spacecraft-design-lab-2019/avionics-motherboard/README.md

# avionics-motherboard
Main flight computer board for the PyCubed-1 spacecraft

Snapshot: 2019-10-24 maholli
<p align="middle">
  
</p>
