spacecraft-design-lab-2019/avionics-motherboard/bot.PNG

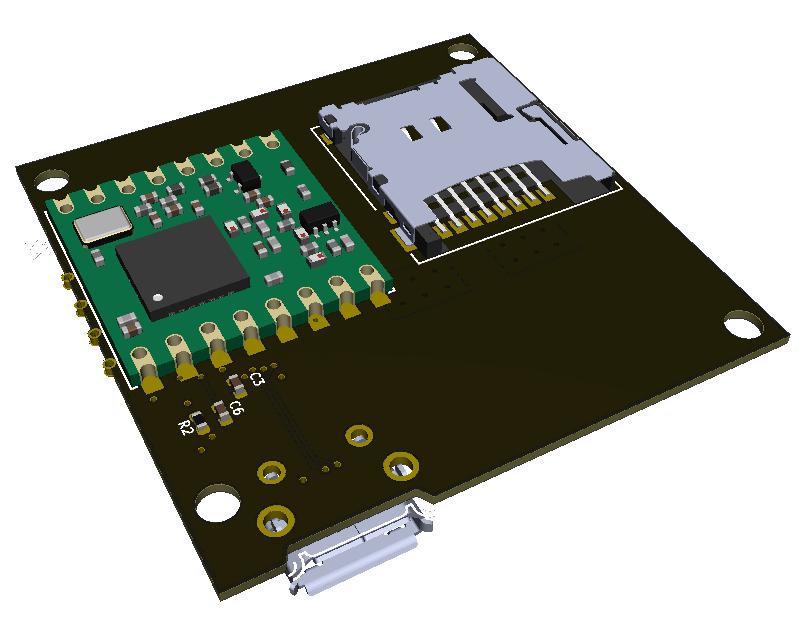
bot.PNG
