spacecraft-design-lab-2019/avionics-motherboard/top.PNG

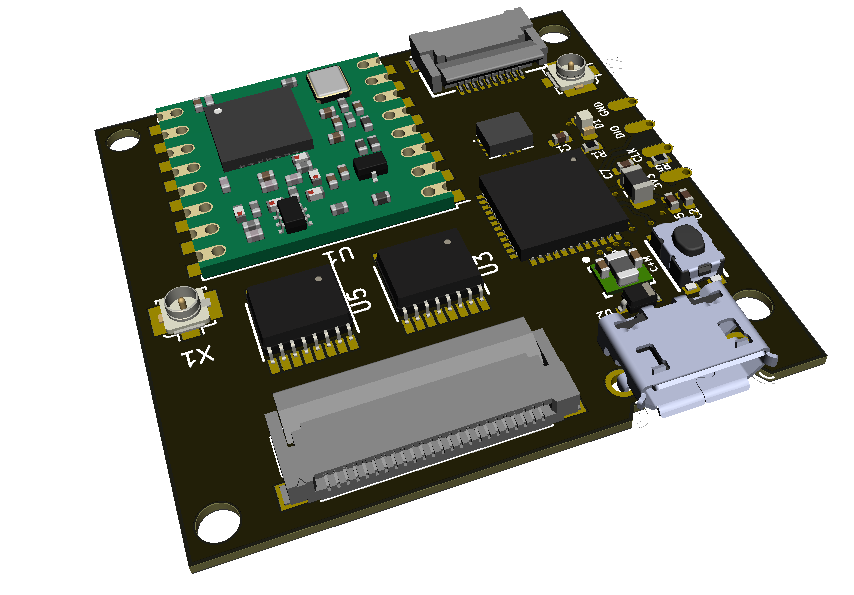
top.PNG
