spacecraft-design-lab-2019/avionics-motherboard/mainboard.kicad_pcb

## KiCad design mainboard.kicad_pcb (2019-10-28)

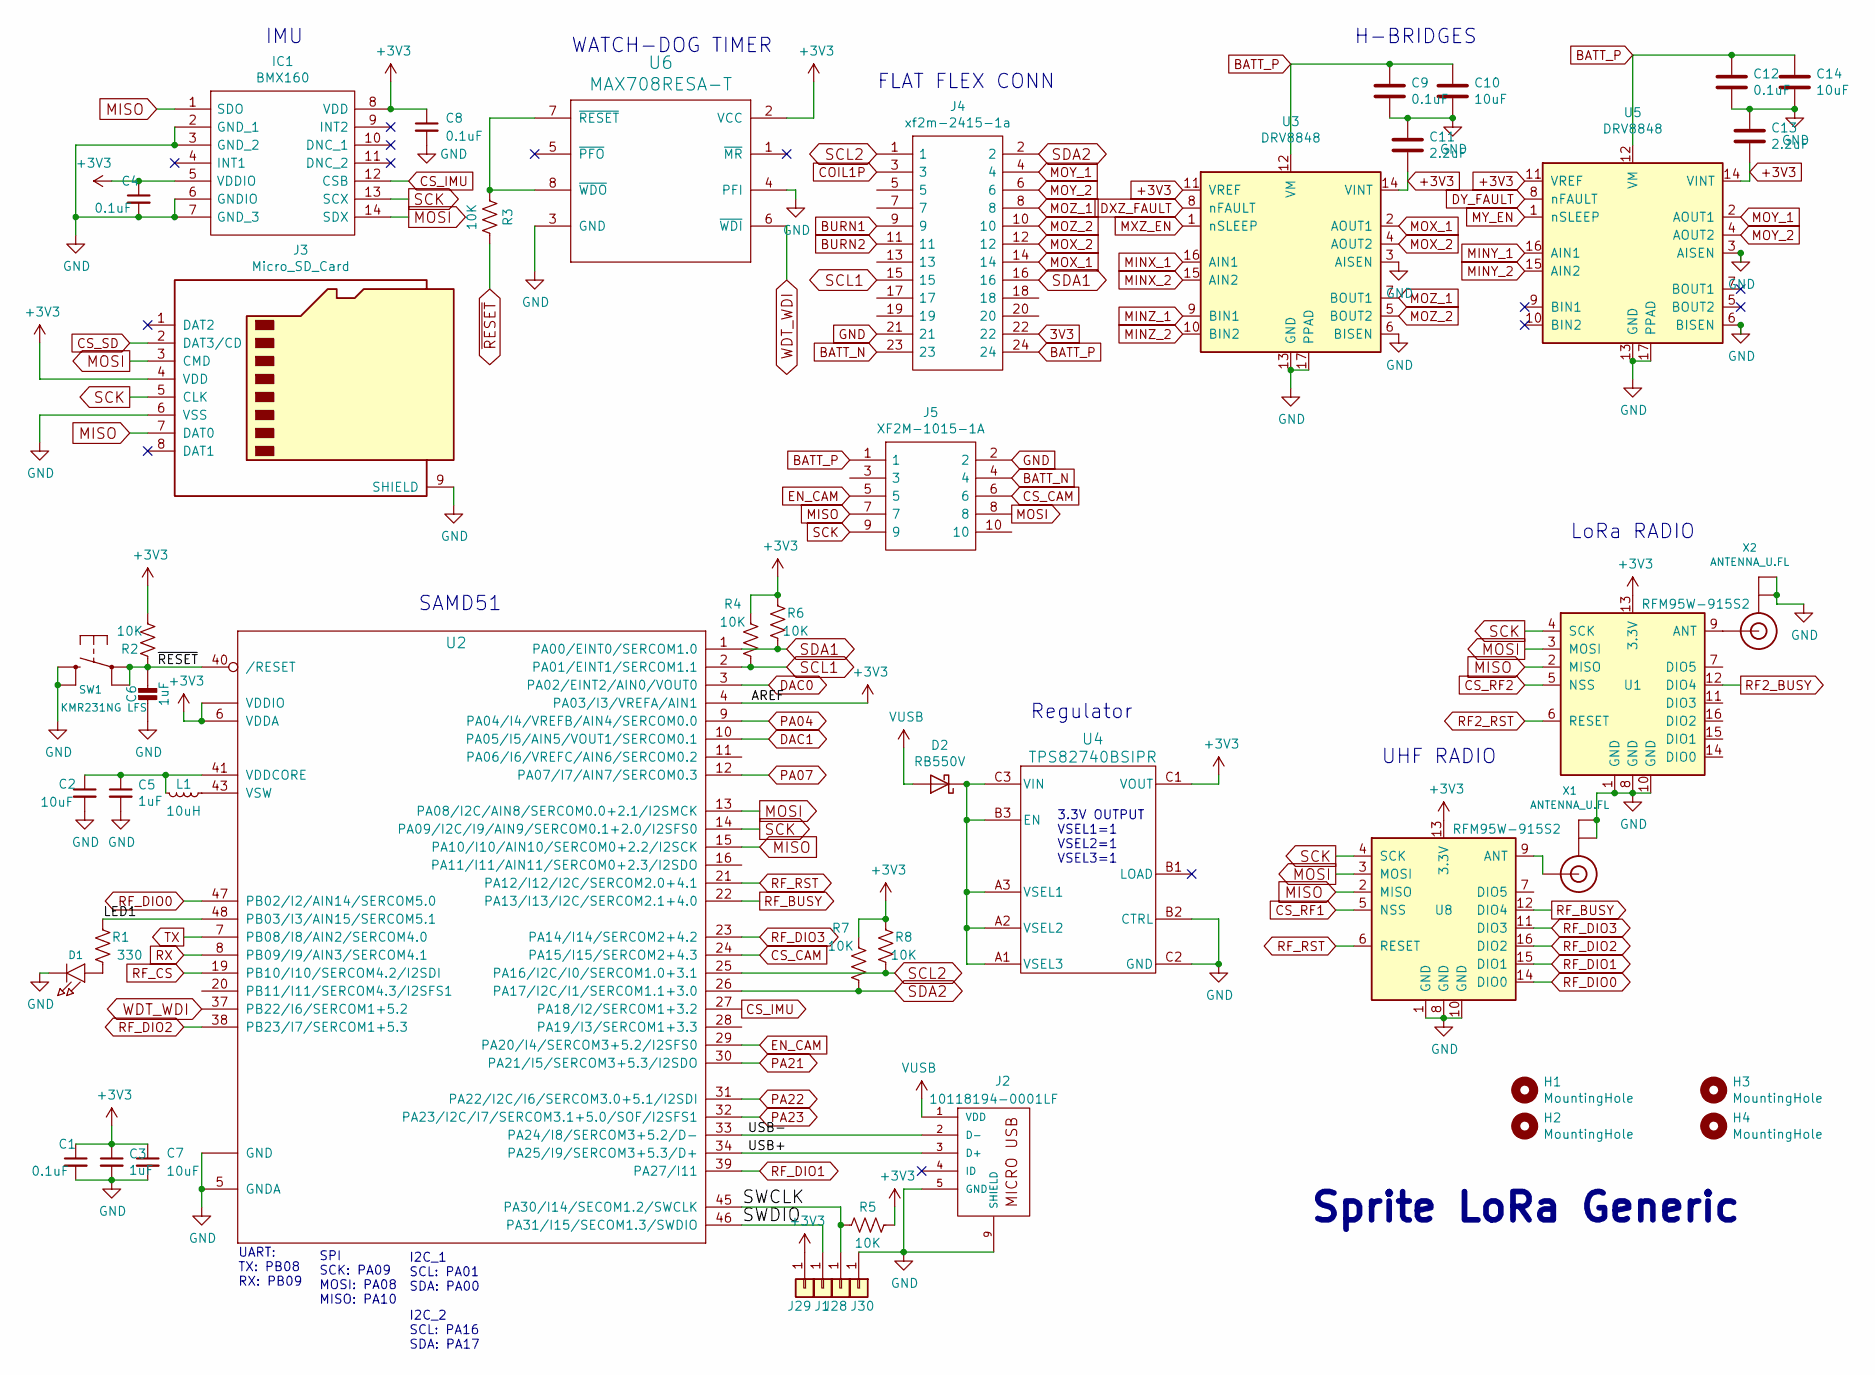
[picture p5: schematic mainboard.sch, Sprite-2019]

Parts:
C1, C4, C8, C9, C12: 0.1uF; C_0402_1005Metric
C2, C7, C10, C14: 10uF; C_0402_1005Metric
C3, C5, C6: 1uF; C_0402_1005Metric
C11, C13: 2.2uF; C_0402_1005Metric
D1: GREEN; LED_0603_1608Metric
D2: RB550V; D_SOD-323
H1, H2, H3, H4: MountingHole; MountingHole_2.2mm_M2
IC1: BMX160; Manufacturer_Part_Number BMX160; Mouser Part Number 262-BMX160
J1, J28, J29, J30: Conn_01x01; castellated_small_1side
J2: 10118194-0001LF
J3: Micro_SD_Card; 503182-1853_MOLEX-MicroSD
J4: xf2m-2415-1a; XF2M-2415-1A
J5: XF2M-1015-1A; Manufacturer_Part_Number XF2M-1015-1A; Mouser Part Number 653-XF2M-1015-1A
L1: 10uH; L_0805_2012Metric
R1: 330; R_0402_1005Metric
R2, R3, R4, R5, R6, R7, R8: 10K; R_0402_1005Metric
SW1: KMR231NG LFS; BTN_KMR2_4.6X2.8
U1, U8: RFM95W-915S2; HOPERF_RFM9XW_SMD
U2: ATSAMD51G_TQFN48; QFN50P700X700X90-49N-D
U3, U5: DRV8848; SOP65P640X120-17N
U4: TPS82740BSIPR; TPS82740ASIPR
U6: MAX708RESA-T; SO-8_3.9x4.9mm_P1.27mm
X1, X2: ANTENNA_U.FL; U.FL_Molex_MCRF_73412-0110_Vertical

Connections:
3V3: J4.22
+3V3: C1.1, C3.1, C4.1, C7.1, C8.1, C11.2, C13.2, IC1.5 (VDDIO), IC1.8 (VDD), J3.4 (VDD), J29.1, R2.2, R4.2, R5.1, R6.2, R7.2, R8.2, U1.13 (3.3V), U2.4 (PA03/I3/VREFA/AIN1), U2.6 (VDDA), U2.17 (VDDIO), U2.36 (VDDIO), U2.44 (VDDIO), U3.11 (VREF), U3.14 (VINT), U4.C1 (VOUT), U5.11 (VREF), U5.14 (VINT), U6.2 (VCC), U8.13 (3.3V)
/LED1: R1.2, U2.48 (PB03/I3/AIN15/SERCOM5.1)
/SWCLK: J28.1, R5.2, U2.45 (PA30/I14/SECOM1.2/SWCLK)
/SWDIO: J1.1, U2.46 (PA31/I15/SECOM1.3/SWDIO)
/USB+: J2.3 (D+), U2.34 (PA25/I9/SERCOM3+5.3/D+)
/USB-: J2.2 (D-), U2.33 (PA24/I8/SERCOM3+5.2/D-)
BATT_N: J4.23, J5.4
BATT_P: C9.1, C10.1, C12.1, C14.1, J4.24, J5.1, U3.12 (VM), U5.12 (VM)
BURN1: J4.9
BURN2: J4.11
COIL1P: J4.3
CS_CAM: J5.6, U2.24 (PA15/I15/SERCOM2+4.3)
CS_IMU: IC1.12 (CSB), U2.27 (PA18/I2/SERCOM1+3.2)
CS_RF1: U8.5 (NSS)
CS_RF2: U1.5 (NSS)
CS_SD: J3.2 (DAT3/CD)
DAC0: U2.3 (PA02/EINT2/AIN0/VOUT0)
DAC1: U2.10 (PA05/I5/AIN5/VOUT1/SERCOM0.1)
DXZ_FAULT: U3.8 (nFAULT)
DY_FAULT: U5.8 (nFAULT)
EN_CAM: J5.5, U2.29 (PA20/I4/SERCOM3+5.2/I2SFS0)
GND: C1.2, C2.2, C3.2, C4.2, C5.2, C6.1, C7.2, C8.2, C9.2, C10.2, C11.1, C12.2, C13.1, C14.2, D1.2, IC1.2 (GND_1), IC1.3 (GND_2), IC1.6 (GNDIO), IC1.7 (GND_3), J2.5 (GND), J2.8, J2.9 (SHIELD), J3.6 (VSS), J3.9 (SHIELD), J4.21, J5.2, J30.1, SW1.B (S), SW1.B' (S1), U1.1 (GND), U1.8 (GND), U1.10 (GND), U2.5 (GNDA), U2.18 (GND), U2.35 (GND), U2.42 (GND), U2.49, U3.3 (AISEN), U3.6 (BISEN), U3.13 (GND), U3.17 (PPAD), U4.B2 (CTRL), U4.C2 (GND), U5.3 (AISEN), U5.6 (BISEN), U5.13 (GND), U5.17 (PPAD), U6.3 (GND), U6.4 (PFI), U8.1 (GND), U8.8 (GND), U8.10 (GND), X1.1 (GND@0), X1.2 (GND@1), X2.1 (GND@0), X2.2 (GND@1)
MINX_1: U3.16 (AIN1)
MINX_2: U3.15 (AIN2)
MINY_1: U5.16 (AIN1)
MINY_2: U5.15 (AIN2)
MINZ_1: U3.9 (BIN1)
MINZ_2: U3.10 (BIN2)
MISO: IC1.1 (SDO), J3.7 (DAT0), J5.7, U1.2 (MISO), U2.15 (PA10/I10/AIN10/SERCOM0+2.2/I2SCK), U8.2 (MISO)
MOSI: IC1.14 (SDX), J3.3 (CMD), J5.8, U1.3 (MOSI), U2.13 (PA08/I2C/AIN8/SERCOM0.0+2.1/I2SMCK), U8.3 (MOSI)
MOX_1: J4.14, U3.2 (AOUT1)
MOX_2: J4.12, U3.4 (AOUT2)
MOY_1: J4.4, U5.2 (AOUT1)
MOY_2: J4.6, U5.4 (AOUT2)
MOZ_1: J4.8, U3.7 (BOUT1)
MOZ_2: J4.10, U3.5 (BOUT2)
MXZ_EN: U3.1 (nSLEEP)
MY_EN: U5.1 (nSLEEP)
unnamed: C2.1, C5.1, L1.2, U2.41 (VDDCORE)
unnamed: D1.1, R1.1
unnamed: D2.1 (K), U4.A1 (VSEL3), U4.A2 (VSEL2), U4.A3 (VSEL1), U4.B3 (EN), U4.C3 (VIN)
unnamed: L1.1, U2.43 (VSW)
unnamed: R3.2, U6.7 (~RESET), U6.8 (~WDO)
unnamed: U1.9 (ANT), X2.3 (SIGNAL)
unnamed: U8.9 (ANT), X1.3 (SIGNAL)
PA04: U2.9 (PA04/I4/VREFB/AIN4/SERCOM0.0)
PA07: U2.12 (PA07/I7/AIN7/SERCOM0.3)
PA21: U2.30 (PA21/I5/SERCOM3+5.3/I2SDO)
PA22: U2.31 (PA22/I2C/I6/SERCOM3.0+5.1/I2SDI)
PA23: U2.32 (PA23/I2C/I7/SERCOM3.1+5.0/SOF/I2SFS1)
RF2_BUSY: U1.12 (DIO4)
RF2_RST: U1.6 (RESET)
RF_BUSY: U2.22 (PA13/I13/I2C/SERCOM2.1+4.0), U8.12 (DIO4)
RF_CS: U2.19 (PB10/I10/SERCOM4.2/I2SDI)
RF_DIO0: U2.47 (PB02/I2/AIN14/SERCOM5.0), U8.14 (DIO0)
RF_DIO1: U2.39 (PA27/I11), U8.15 (DIO1)
RF_DIO2: U2.38 (PB23/I7/SERCOM1+5.3), U8.16 (DIO2)
RF_DIO3: U2.23 (PA14/I14/SERCOM2+4.2), U8.11 (DIO3)
RF_RST: U2.21 (PA12/I12/I2C/SERCOM2.0+4.1), U8.6 (RESET)
RX: U2.8 (PB09/I9/AIN3/SERCOM4.1)
SCK: IC1.13 (SCX), J3.5 (CLK), J5.9, U1.4 (SCK), U2.14 (PA09/I2C/I9/AIN9/SERCOM0.1+2.0/I2SFS0), U8.4 (SCK)
SCL1: J4.15, R4.1, U2.2 (PA01/EINT1/SERCOM1.1)
SCL2: J4.1, R8.1, U2.25 (PA16/I2C/I0/SERCOM1.0+3.1)
SDA1: J4.16, R6.1, U2.1 (PA00/EINT0/SERCOM1.0)
SDA2: J4.2, R7.1, U2.26 (PA17/I2C/I1/SERCOM1.1+3.0)
TX: U2.7 (PB08/I8/AIN2/SERCOM4.0)
VUSB: D2.2 (A), J2.1 (VDD)
WDT_WDI: U2.37 (PB22/I6/SERCOM1+5.2), U6.6 (~WDI)
~RESET: C6.2, R2.1, R3.1, SW1.A, SW1.A' (P1), U2.40 (/RESET)

Notes on the sheet:
Regulator
3.3V OUTPUT VSEL1=1 VSEL2=1 VSEL3=1
SAMD51
UHF RADIO
Sprite LoRa Generic
LoRa RADIO
H-BRIDGES
WATCH-DOG TIMER
IMU
FLAT FLEX CONN
UART: TX: PB08 RX: PB09
SPI SCK: PA09 MOSI: PA08 MISO: PA10
I2C_1 SCL: PA01 SDA: PA00 I2C_2 SCL: PA16 SDA: PA17

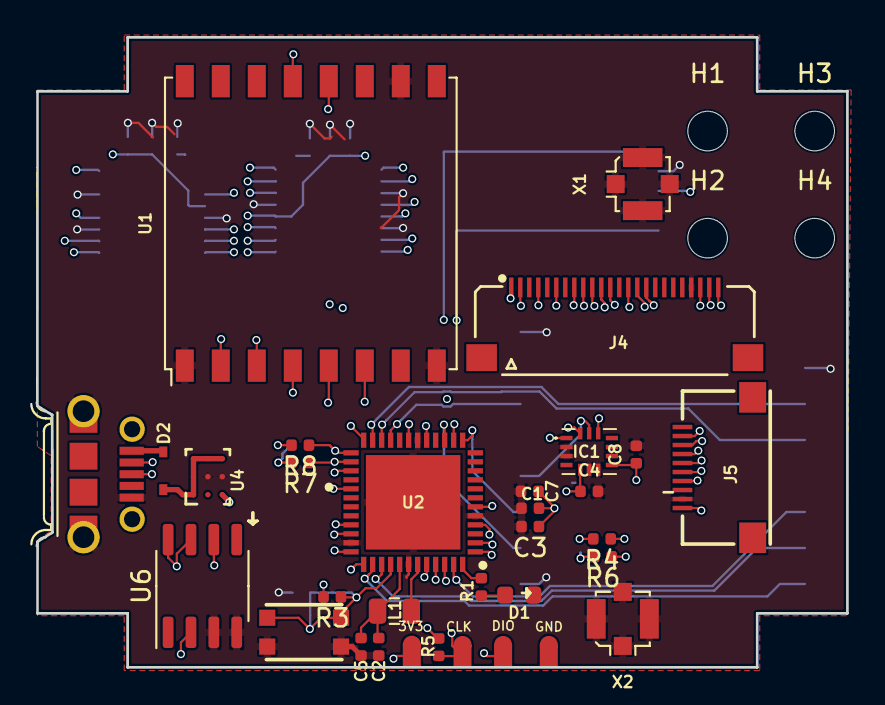
[picture p6: board mainboard.kicad_pcb from above]

Board: 4 copper layers, 45.0 x 35.0 mm, 48 parts (0 on the bottom side), 39 nets.
