spacecraft-design-lab-2019/avionics-motherboard/rf-test/spriteSAMD.kicad_pcb

## KiCad design rf-test/spriteSAMD.kicad_pcb (2019-10-27)

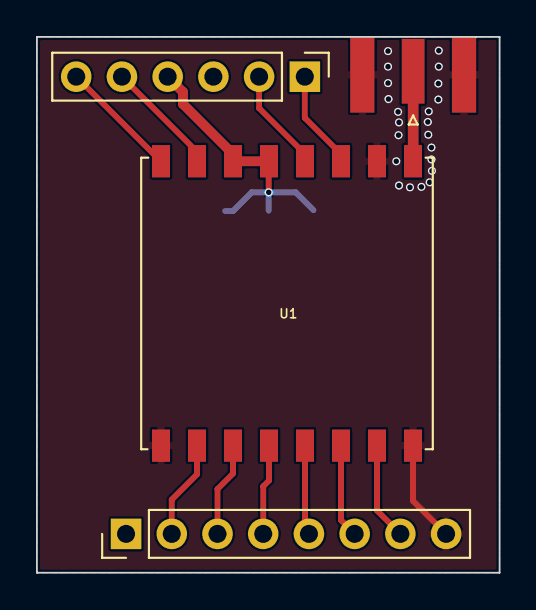
[picture p7: board spriteSAMD.kicad_pcb from above]

Board: 2 copper layers, 25.7 x 29.8 mm, 7 parts (0 on the bottom side), 13 nets.

Parts:
C1: 0.1uF; C_0402_1005Metric
C2: 1uF; C_0402_1005Metric
C3: 10uF; C_0402_1005Metric
J1: Conn_01x08_Female; PinHeader_1x08_P2.54mm_Vertical
J2: Conn_Coaxial; SMA_Samtec_SMA-J-P-H-ST-EM1_EdgeMount
J3: Conn_01x08_Female; PinHeader_1x06_P2.54mm_Vertical
U1: RFM95W-915S2; HOPERF_RFM9XW_SMD

Connections:
GND: C1.2, C2.2, C3.2, J1.8, J2.2, U1.1, U1.8, U1.10
MISO: J1.2, U1.2
MOSI: J1.3, U1.3
unnamed: J2.1, U1.9
P7: J1.7, U1.7
RF_BUSY: J3.2, U1.12
RF_CS: J1.5, U1.5
RF_DIO0: C1.1, C2.1, C3.1, J3.4, U1.13, U1.14
RF_DIO1: J3.5, U1.15
RF_DIO2: J3.6, U1.16
RF_DIO3: J3.1, U1.11
RF_RST: J1.6, U1.6
SCK: J1.4, U1.4
