spacecraft-design-lab-2019/avionics-motherboard/(commit log)

2019-10-19 the will-it-all-fit test... ✔
    [Motherboard.kicad_pcb, Motherboard.sch, spriteSAMD.kicad_pcb, spriteSAMD.sch]
2019-10-19 if I fits... 😺
2019-10-19 added WDT and took closer-look at fit
    [spriteSAMD.kicad_pcb]
2019-10-19 labeled schematic in case anyone ends up seeing this
    [spriteSAMD.kicad_pcb, spriteSAMD.sch]
2019-10-20 changed KiCad project name and fixed linking
    [mainboard.kicad_pcb, mainboard.sch, spriteSAMD.kicad_pcb, spriteSAMD.sch]
2019-10-21 deleted battery connector (should be apart of 24-pin FPC)
    [mainboard.sch]
2019-10-21 Motherboard files 10/21/2019
    Added Hbridge circuit, also added netlabels for camera connector
    [mainboard.kicad_pcb, mainboard.sch, spriteSAMD.kicad_pcb, spriteSAMD.sch]
2019-10-24 branching for fabrication clean-up and review
    [mainboard.kicad_pcb, mainboard.sch]
2019-10-24 placement clean-up
    [mainboard.kicad_pcb, mainboard.sch]
2019-10-24 placement getting closer
    [mainboard.kicad_pcb, mainboard.sch]
2019-10-24 placement roughed-in & routing planned
    [mainboard.kicad_pcb, mainboard.sch]
2019-10-24 rearranging for power distrobution
    [mainboard.kicad_pcb, mainboard.sch]
2019-10-24 much cleaner SPI and BATT_P layout
    [mainboard.kicad_pcb]
2019-10-24 ~75% routed
    [mainboard.kicad_pcb, mainboard.sch]
2019-10-24 routing ~80%
    [mainboard.kicad_pcb, mainboard.sch]
2019-10-24 routed except for connectors
    [mainboard.kicad_pcb, mainboard.sch]
2019-10-24 changed IMU from SPI to I2C for pins
    [mainboard.kicad_pcb]
2019-10-24 lots of clean up
    [mainboard.kicad_pcb, mainboard.sch]
2019-10-24 putting matching coils in series
    [mainboard.sch]
2019-10-24 coil bridges with contingency finished
    [mainboard.kicad_pcb, mainboard.sch]
2019-10-24 big FPC routed
    [mainboard.kicad_pcb, mainboard.sch]
2019-10-24 neopixel 🚥
    [mainboard.kicad_pcb]
2019-10-24 adding pdf of schematic
    [mainboard.sch]
2019-10-25 100% routed
    [mainboard.kicad_pcb, mainboard.sch]
2019-10-25 finished- might fiddle with later
    [mainboard.kicad_pcb, mainboard.sch]
2019-10-26 fab files for max version of MB
    [mainboard-B_Mask.gbs, mainboard-B_Paste.gbp, mainboard-B_SilkS.gbo, mainboard-Bottom.gbl, mainboard-Edge_Cuts.gm1, mainboard-F_Mask.gts, mainboard-F_Paste.gtp, mainboard-F_SilkS.gto]
2019-10-26 JLCPCB fab output
    [mainboard-B_Mask.gbr, mainboard-B_Paste.gbr, mainboard-B_SilkS.gbr, mainboard-Bottom.gbr, mainboard-Edge_Cuts.gbr, mainboard-F_Mask.gbr, mainboard-F_Paste.gbr, mainboard-F_SilkS.gbr]
2019-10-26 interactive BOM
2019-10-27 rftest ready for fab
    [spriteSAMD-B_Mask.gbr, spriteSAMD-B_Paste.gbr, spriteSAMD-B_SilkS.gbr, spriteSAMD-Bottom.gbr, spriteSAMD-Edge_Cuts.gbr, spriteSAMD-F_Mask.gbr, spriteSAMD-F_Paste.gbr, spriteSAMD-F_SilkS.gbr]
2019-10-28 generating 3D CAD
    [mainboard.kicad_pcb]
2019-11-01 stencil outputs
    [mainboard.kicad_pcb]
